paolpal/bartop-arcade/cabinato_arcade_cadcraft.pdf

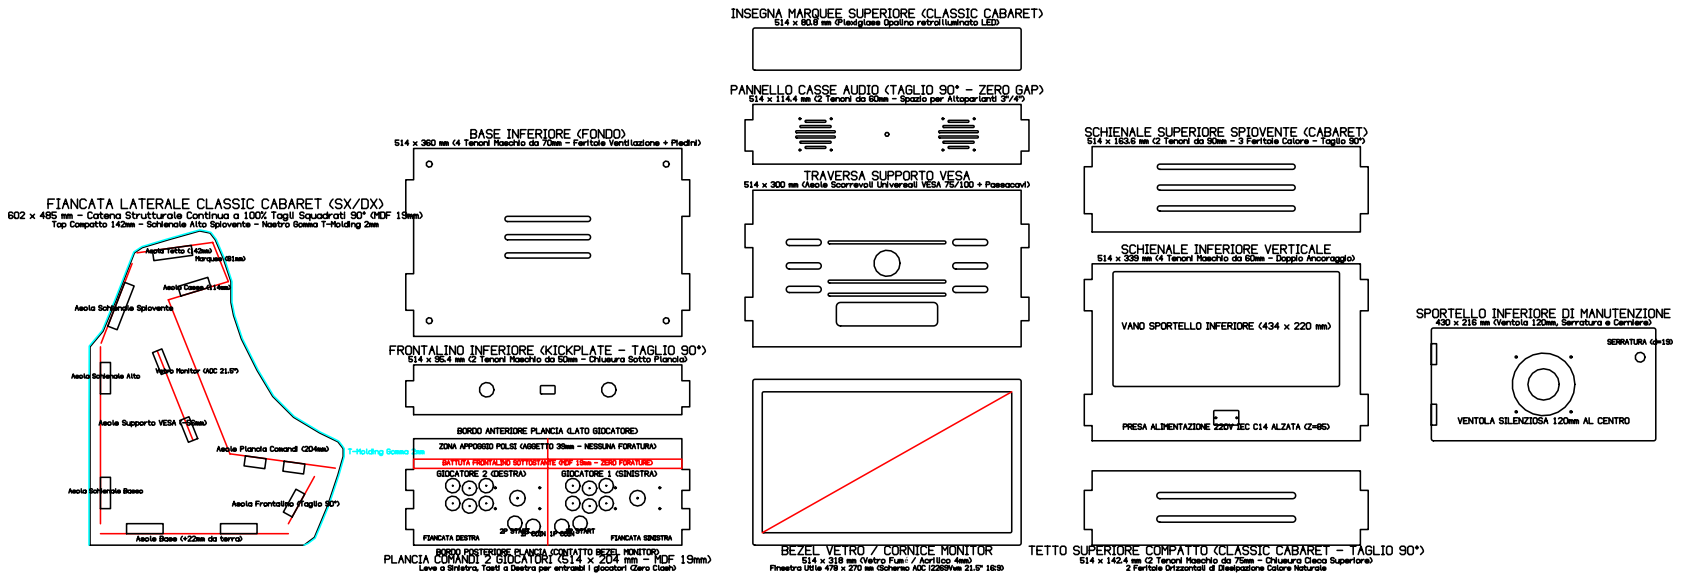
[picture p2: page 1]
