paolpal/bartop-arcade/cabinato_arcade_3d.step

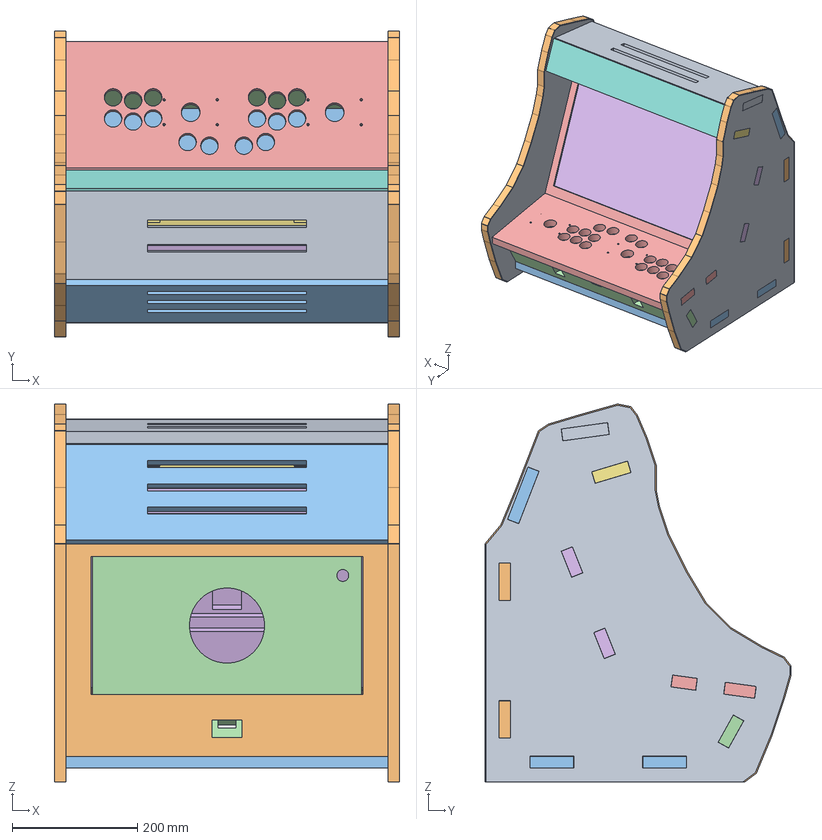
[picture p1: CAD file, 2026-10-28]
cabinato_arcade_3d.step
552.0 x 489.0 x 604.0 mm
