paolpal/bartop-arcade/(list of files, cad)

Other CAD files:
cabinato_arcade_cadcraft.dxf
